HarshParmar029/EcoFarm-AI/docs/circuit-schematic.png

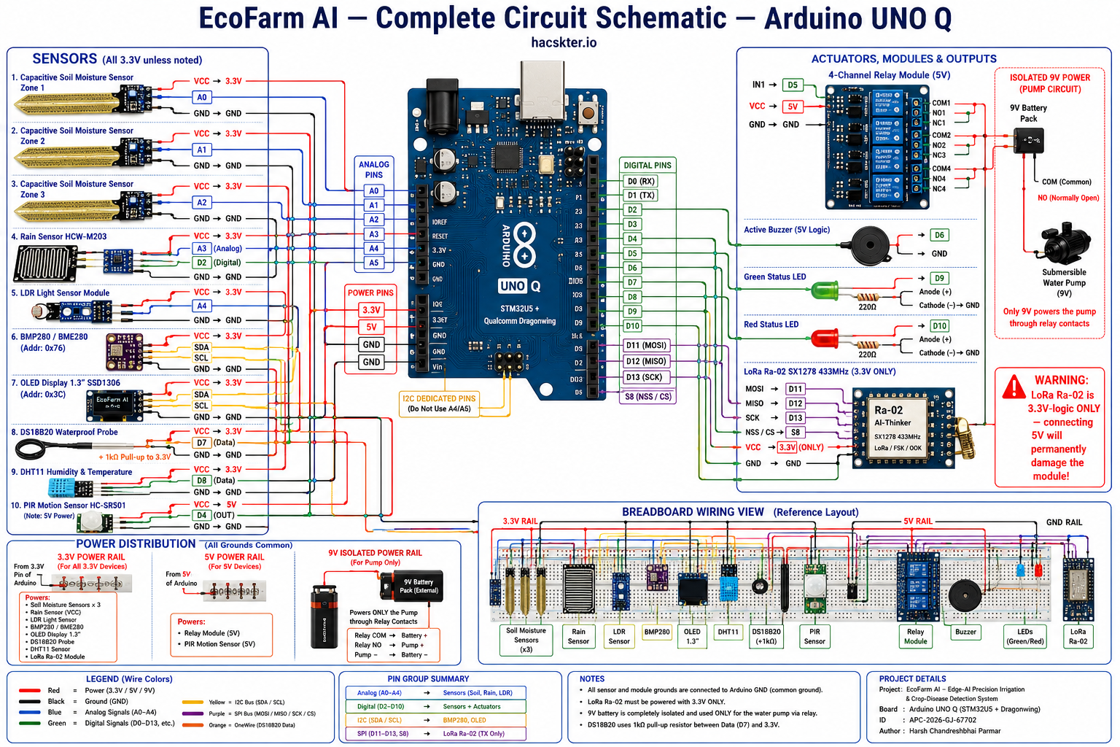
docs/circuit-schematic.png
