HarshParmar029/EcoFarm-AI/docs/receipt Of Arduino UNO Q.pdf

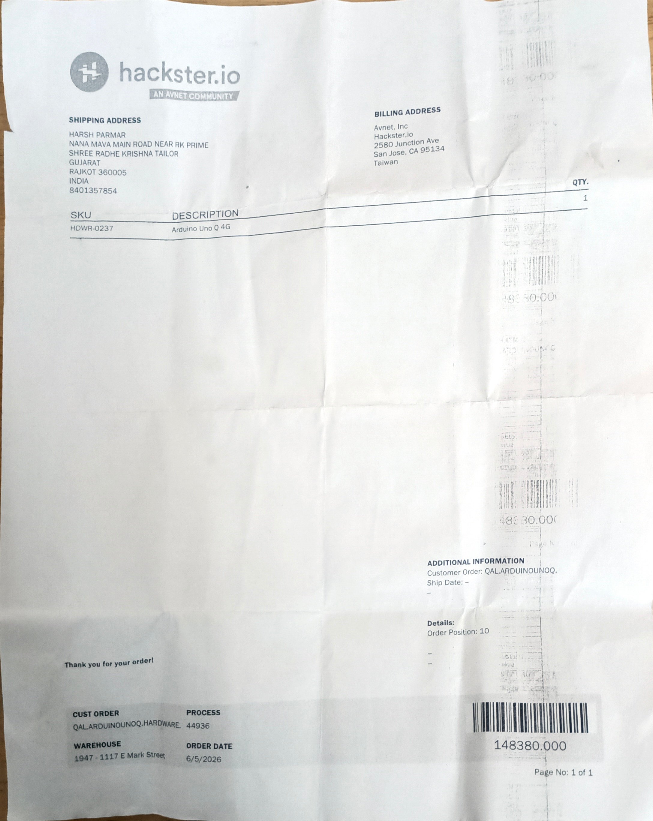
[picture p3: page 1]
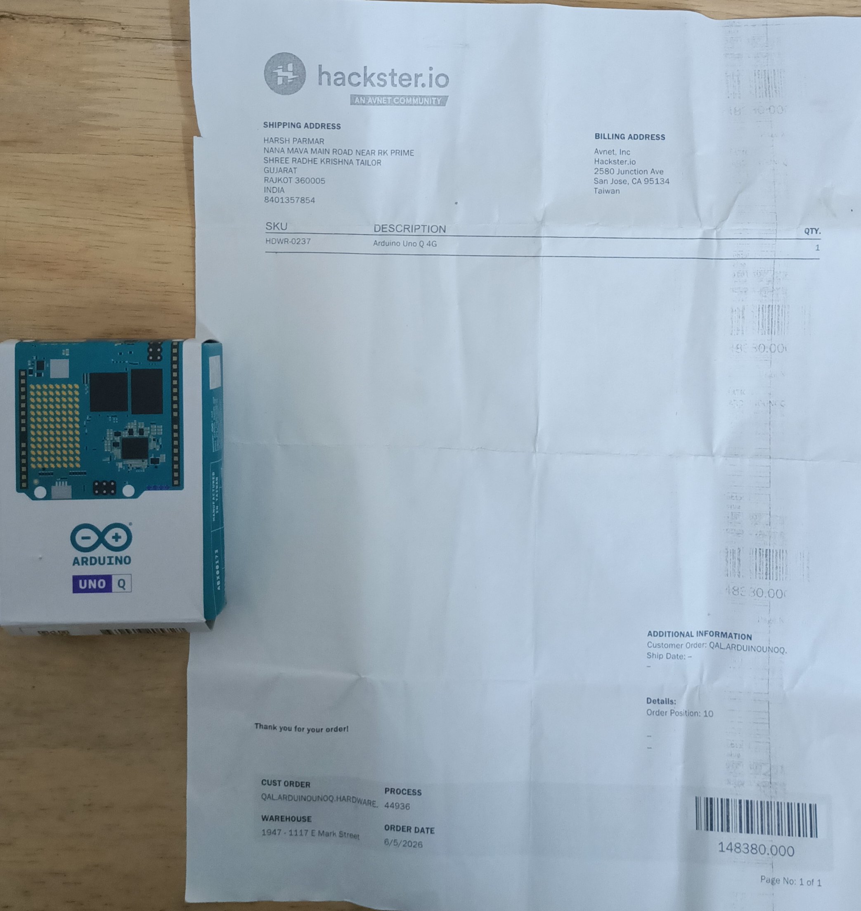
[picture p4: page 2]
