HarshParmar029/EcoFarm-AI/(notices)

Notices in the files:
README.md:
License: MIT
